senmag-robotics/Autgrip-Parts/3D_parts/actuator_spool.stl

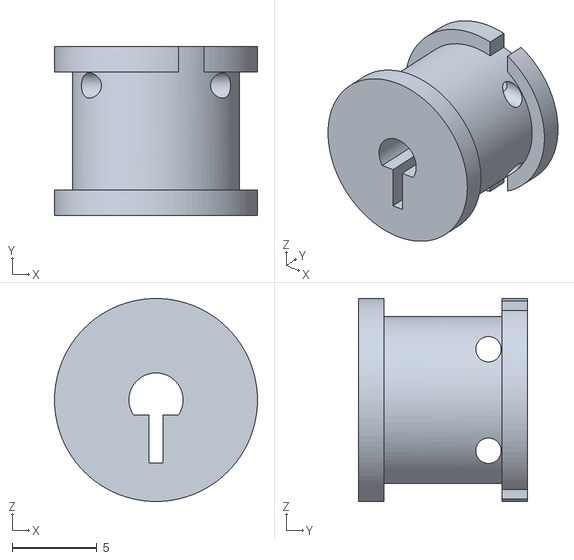
[picture p1: CAD file, 2020-12-04]
3D_parts/actuator_spool.stl
12.0 x 10.0 x 12.0
