senmag-robotics/Autgrip-Parts/3D_parts/gimbal_a.stl

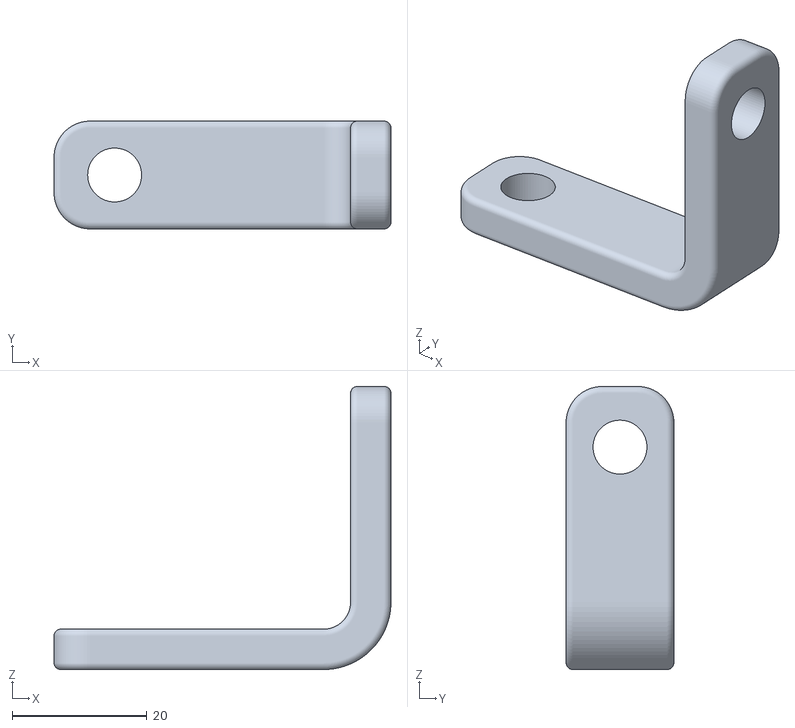
[picture p2: CAD file, 2020-12-04]
3D_parts/gimbal_a.stl
50.0 x 16.0 x 42.0
