senmag-robotics/Autgrip-Parts/3D_parts/gimbal_b.stl

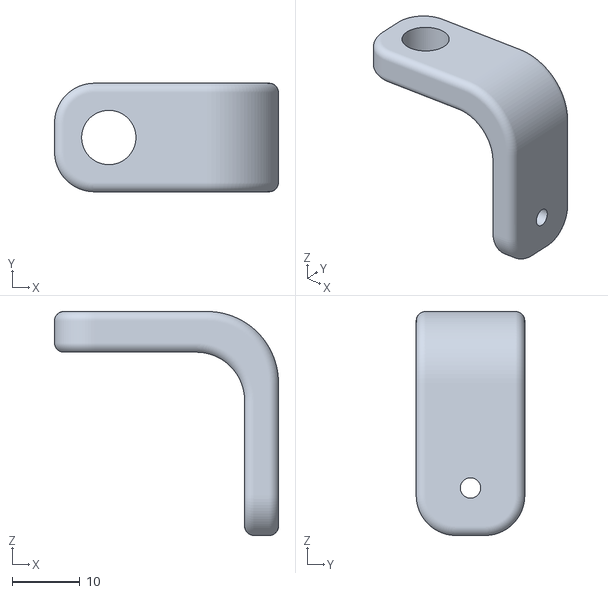
[picture p3: CAD file, 2020-12-04]
3D_parts/gimbal_b.stl
33.0 x 16.0 x 33.0
