senmag-robotics/Autgrip-Parts/3D_parts/thimble_a.stl

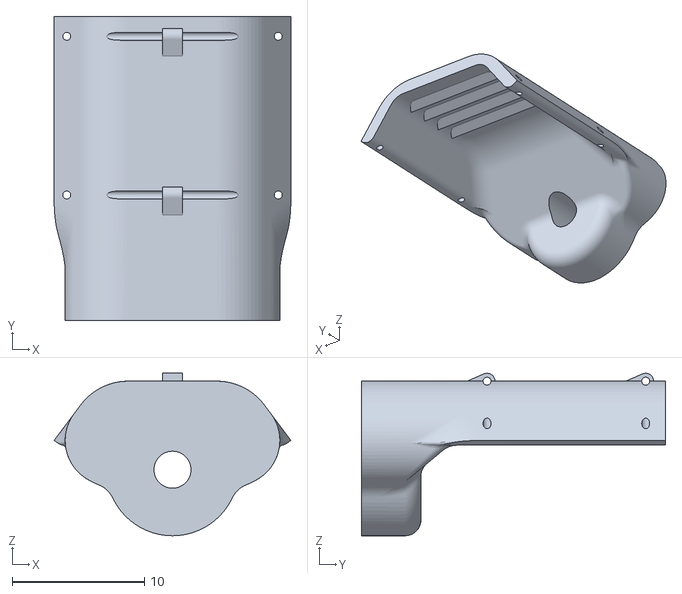
[picture p4: CAD file, 2020-12-04]
3D_parts/thimble_a.stl
17.9 x 23.0 x 12.3
