senmag-robotics/Autgrip-Parts/3D_parts/thimble_b.stl

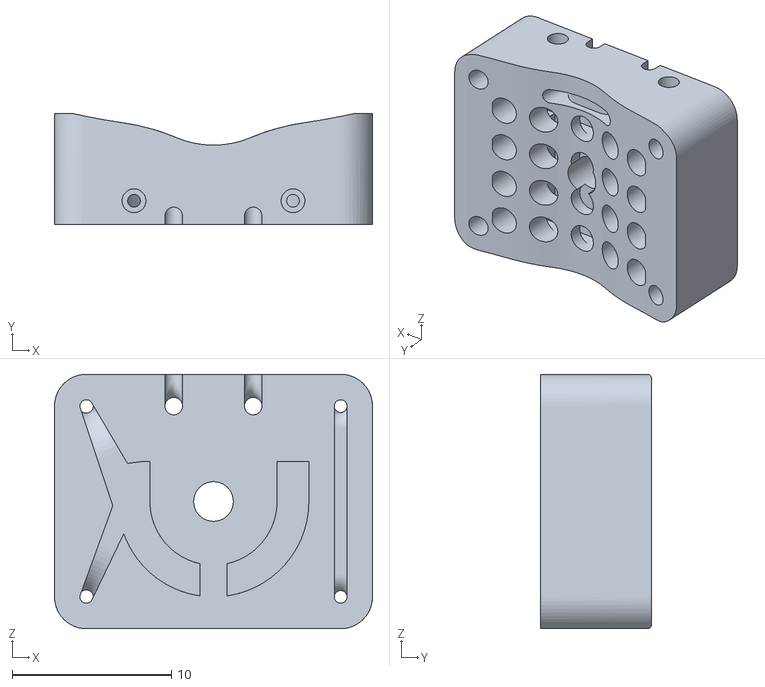
[picture p5: CAD file, 2020-12-04]
3D_parts/thimble_b.stl
20.0 x 7.00 x 16.0
