senmag-robotics/Autgrip-Parts/3D_parts/actuator_chassis.stl

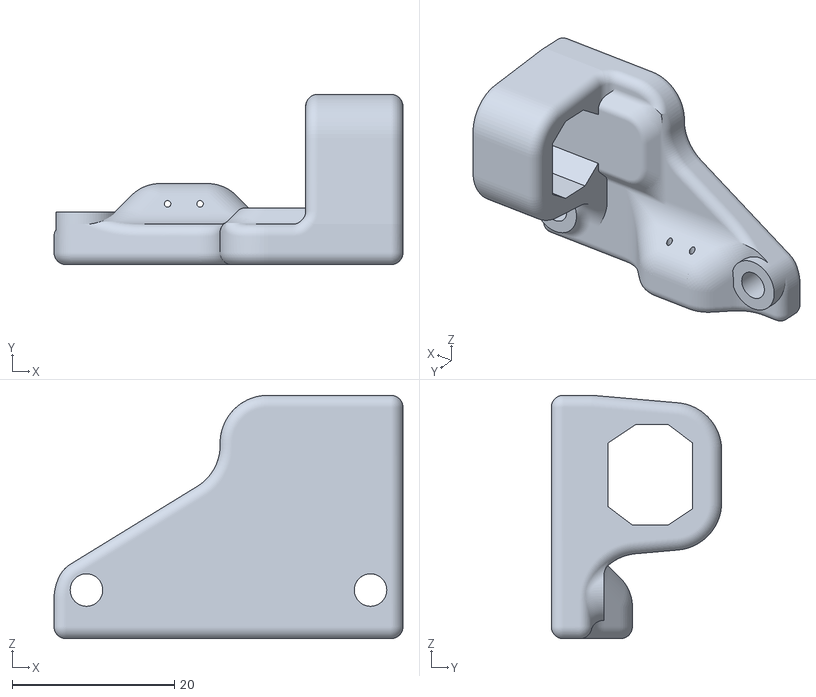
[picture p6: CAD file, 2020-12-04]
3D_parts/actuator_chassis.stl
43.0 x 21.0 x 30.0
