senmag-robotics/Autgrip-Parts/tutorial.pdf

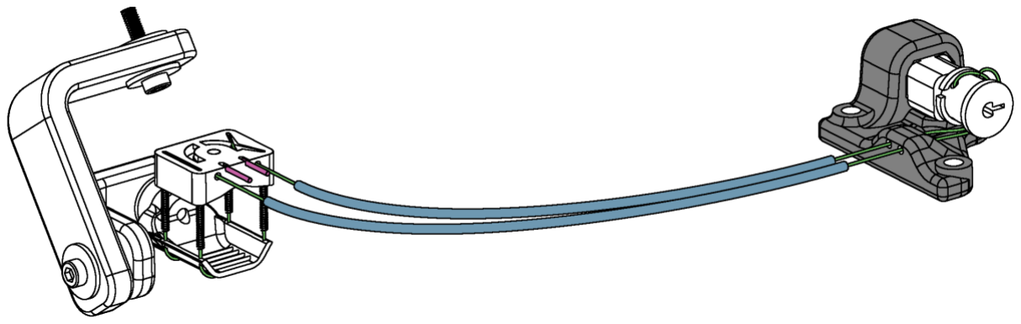
[picture p7: figure]

P a g e 1 | 12

# Autogrip Assembly Guide

# Version 1.0

## Table of Contents

## Introduction:

This document contains instructions for assembling Autogrip, an autonomously attaching thimble for haptic / force feedback devices.

The next section in this document is the part index. This lists all of the major components needed to assemble an Autogrip thimble. This is followed by sections of step-by-step instructions to assemble the parts.

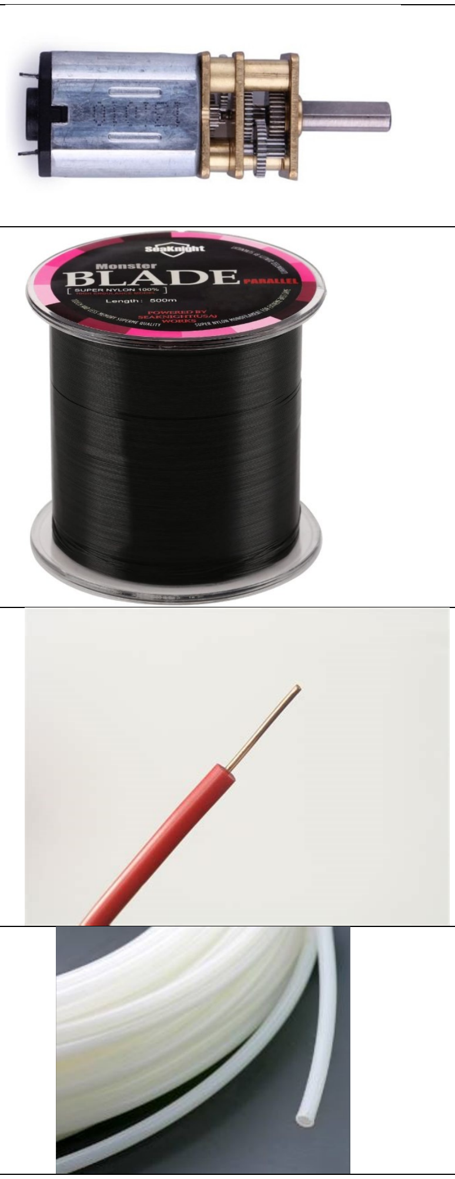
[picture p8: figure]

P a g e 2 | 12

## Part index:

Part reference | Description | Image
N20 Motor (30 RPM) | DC motor used for the actuator
Nylon fishing line (~0.5mm diameter) | Used to connect the actuator to the thimble sections
Electrical wire | Single core electrical wire for the capacitive sensor (remove insulation)
PTFE Teflon tube (~1mm ID, 2mm OD) | Used as Bowden tubes to connect the thimble to the actuator

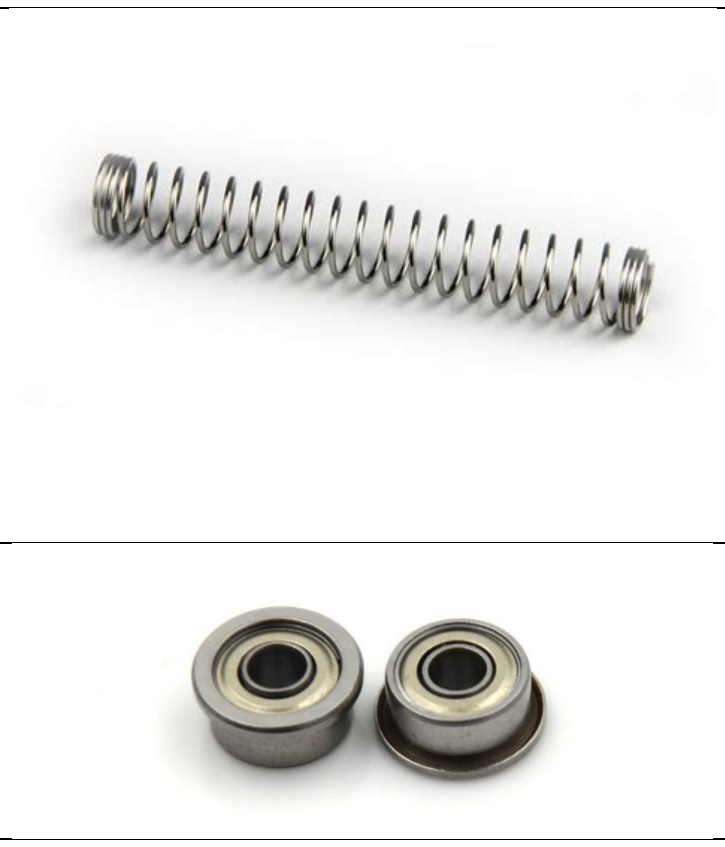
[picture p9: figure]
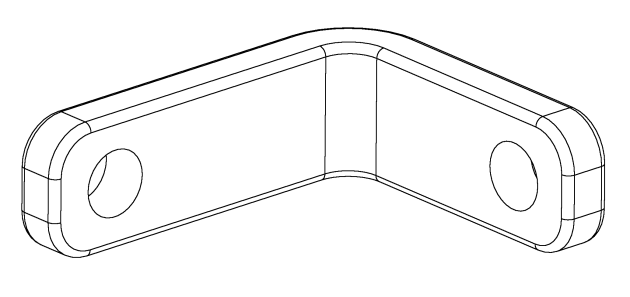
[picture p10: figure]
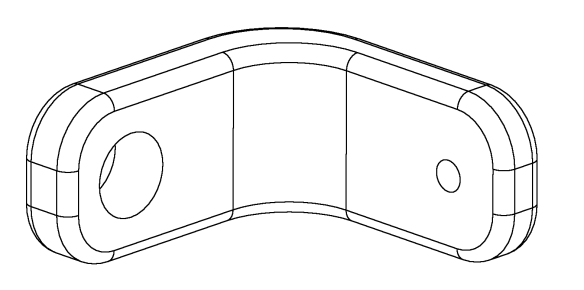
[picture p11: figure]

P a g e 3 | 12
Pen spring | Quantity: 4 Used to keep the thimble sections apart. Approx. 2mm diameter and 14mm length.
Flanged bearing (3mm ID, 8mm OD 9 mm flange) | Quantity: 6 Used for the gimbal sections
M3 15mm cap Bolt | Quantity: 3 Used for the gimbal sections
Gimbal part A | 3D printed (gimbal_a.stl) 100% infill wider nozzle is better (0.6-0.8mm)
Gimbal part B | 3D printed (gimbal_b.stl) 100% infill wider nozzle is better (0.6-0.8mm)

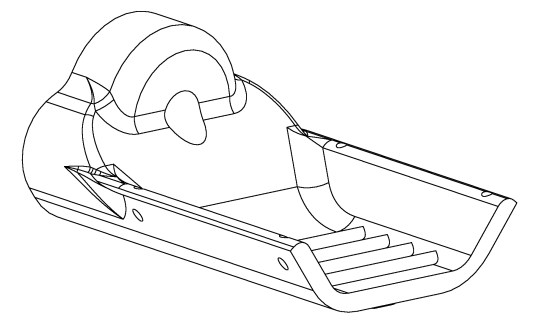
[picture p12: figure]
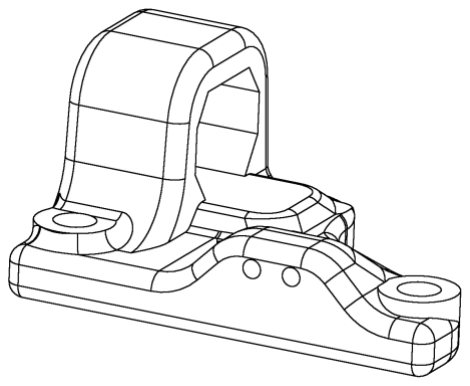
[picture p13: figure]

P a g e 4 | 12
Thimble part A | 3D printed (thimble_a.stl) 100% infill smaller nozzle is better (0.2-0.3mm)

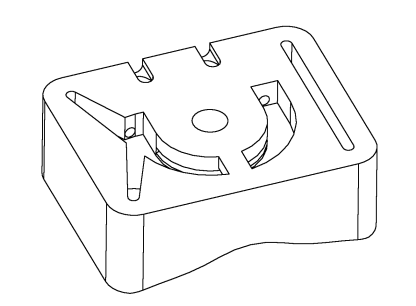
[picture p14: figure]

Thimble part B | 3D printed (thimble_b.stl) 100% infill smaller nozzle is better (0.2-0.3mm)
Actuator chassis | 3D printed (actuator_chassis.stl) medium infill wider nozzle is better (0.6-0.8mm)

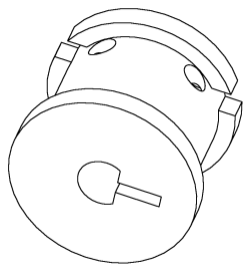
[picture p15: figure]

Actuator spool | 3D printed (actuator_spool.stl) 100% infill smaller nozzle is better (0.2-0.3mm)

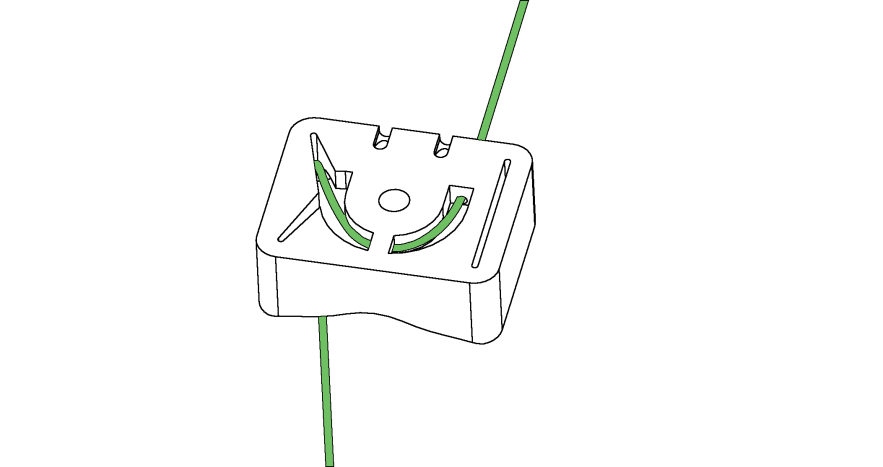
[picture p16: figure]

P a g e 5 | 12

## Assembly Guide:

### Step 1, cut the bowden tubes to length

Decide how long you want the Bowden cables for your thimble. We advise mounting the actuator near the base of the haptic device to reduce inertia. (we used roughly 40cm for a phantom 1.5)

Cut two lengths of PTFE tube with scissors or wire cutters.

### Step 2, start winding the fishing line through the thimble

Take the end of the fishing line (do not cut it from the reel yet) and pass it through Thimble part B as shown:

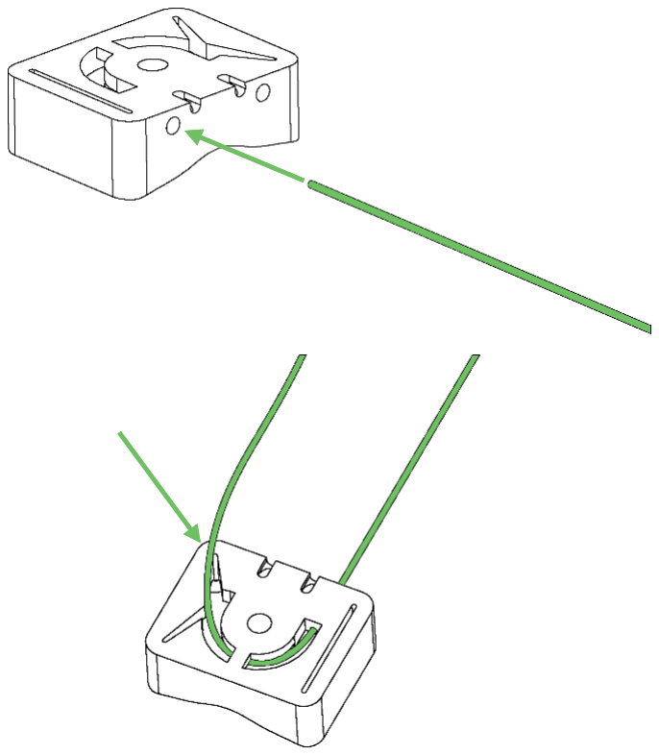
[picture p17: figure]
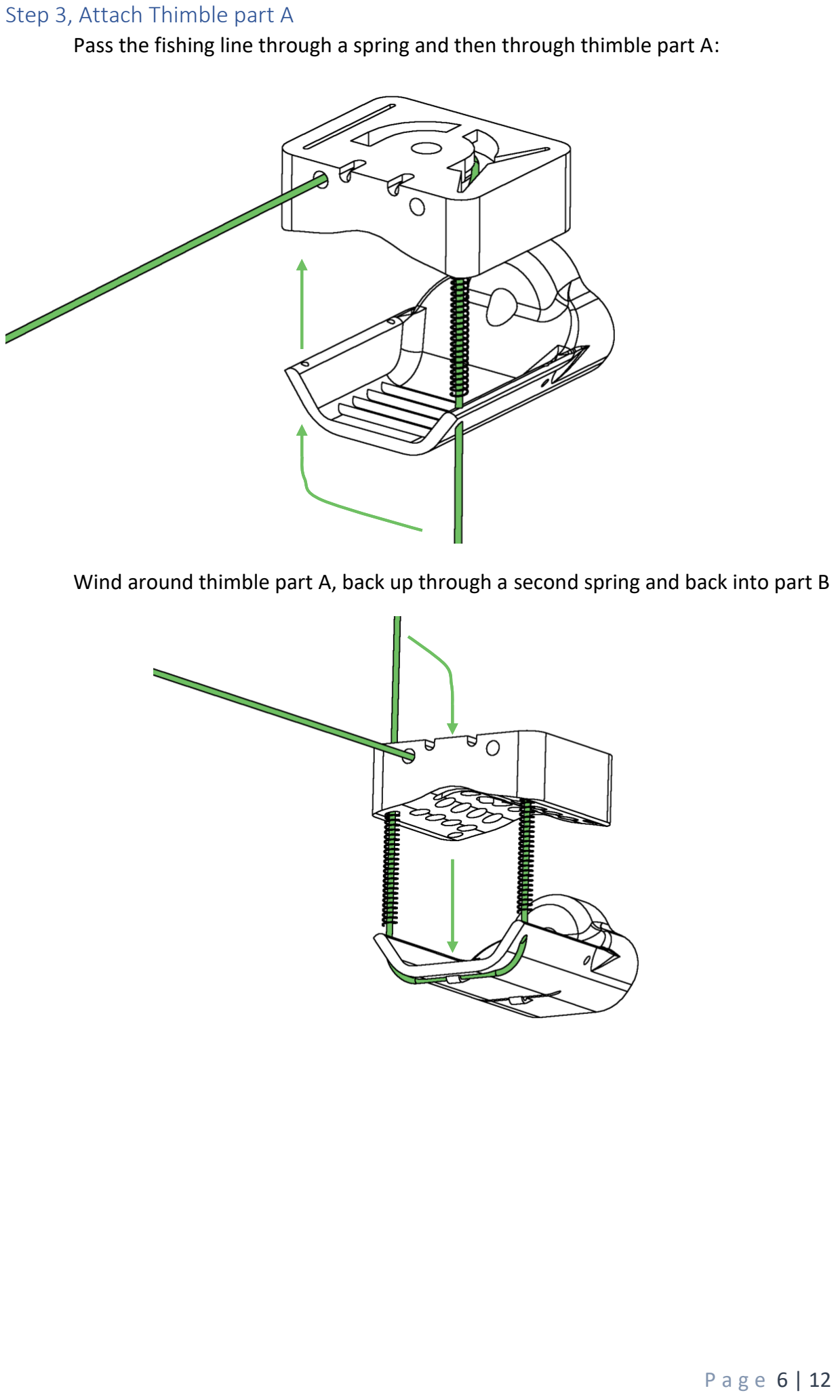
[picture p18: page 6]

P a g e 6 | 12

### Step 3, Attach Thimble part A

Pass the fishing line through a spring and then through thimble part A:

### Step 4, Wind the second half of thimble part A

Wind around thimble part A, back up through a second spring and back into part B

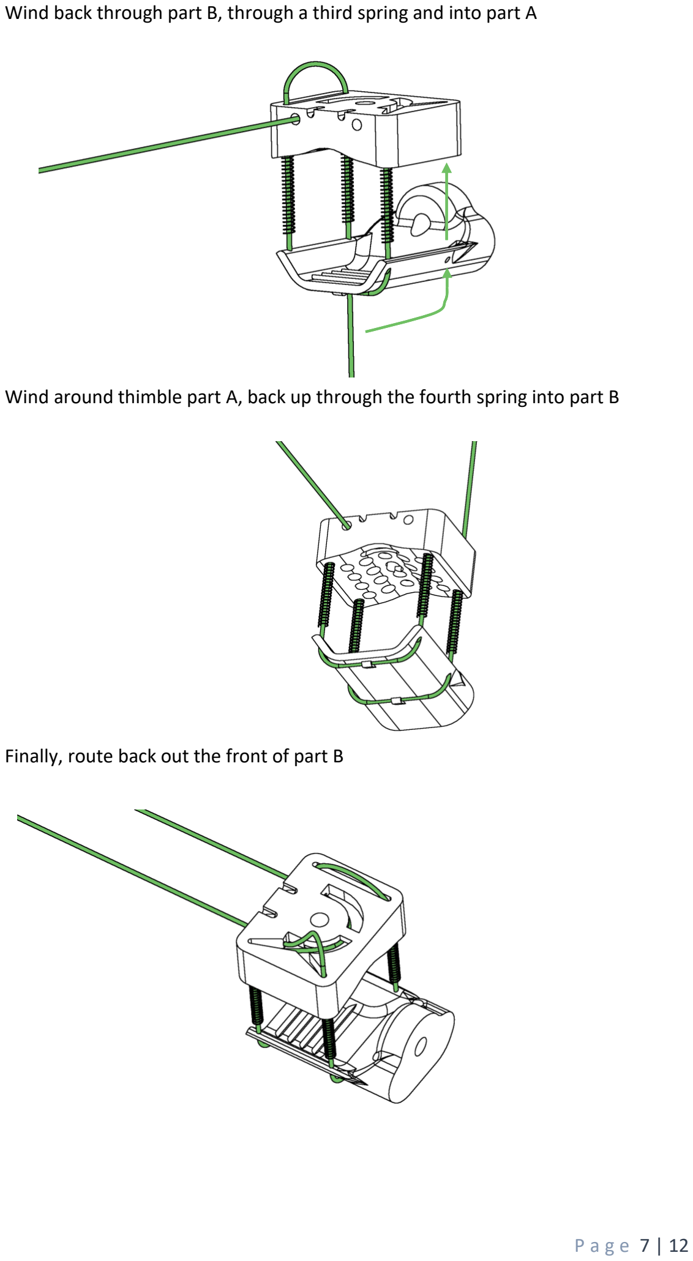
[picture p19: page 7]

P a g e 7 | 12

Wind back through part B, through a third spring and into part A

Wind around thimble part A, back up through the fourth spring into part B

Finally, route back out the front of part B

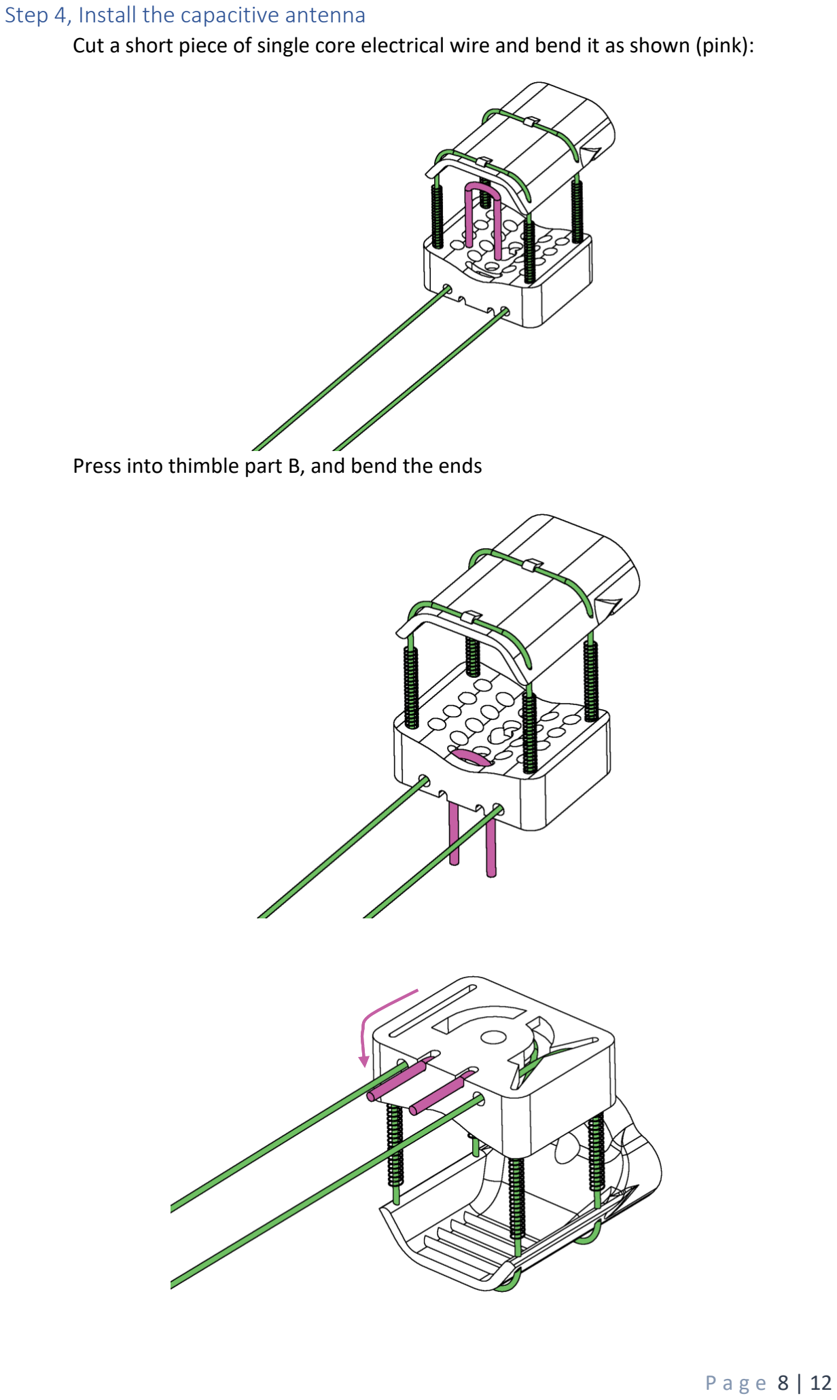
[picture p20: page 8]

P a g e 8 | 12

### Step 4, Install the capacitive antenna

Cut a short piece of single core electrical wire and bend it as shown (pink):

Press into thimble part B, and bend the ends

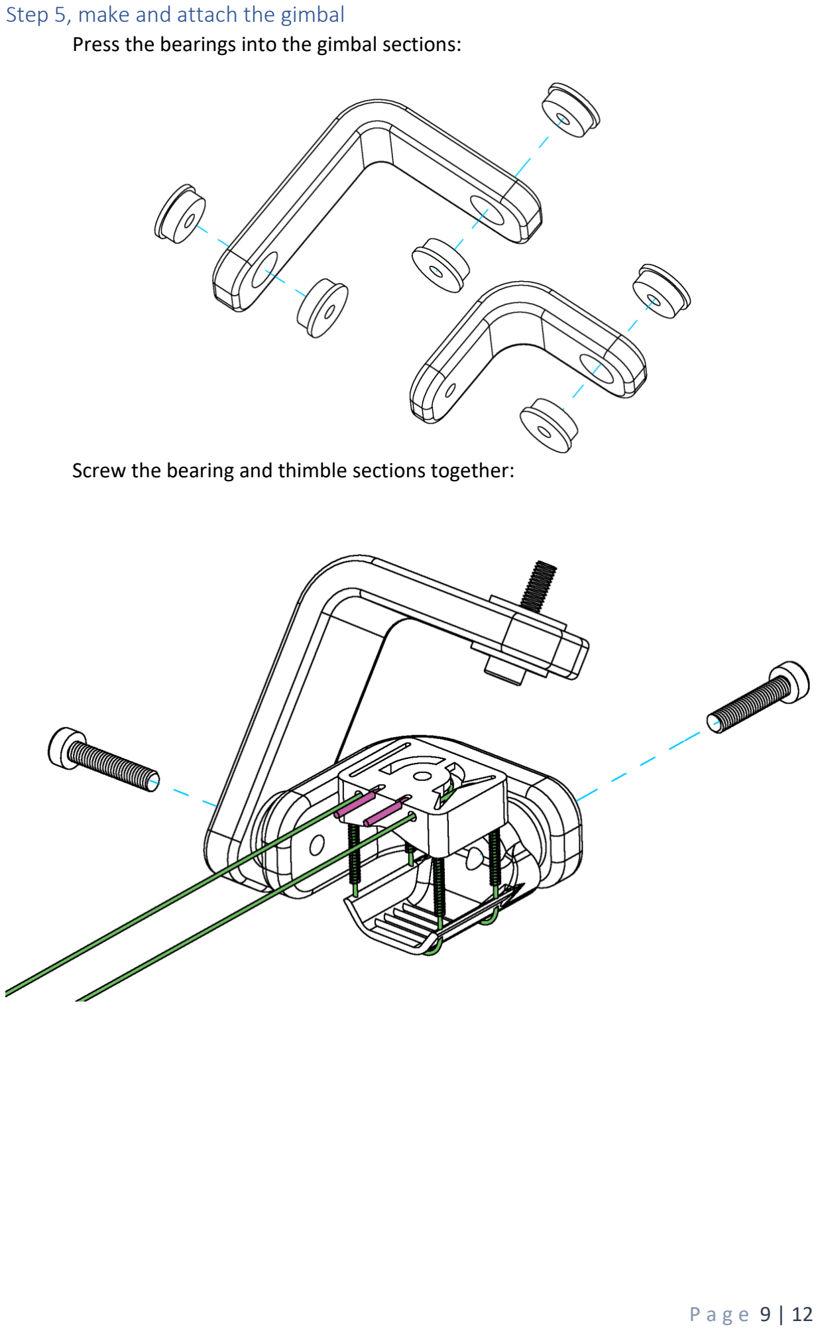
[picture p21: page 9]

P a g e 9 | 12

### Step 5, make and attach the gimbal

Press the bearings into the gimbal sections:

Screw the bearing and thimble sections together:

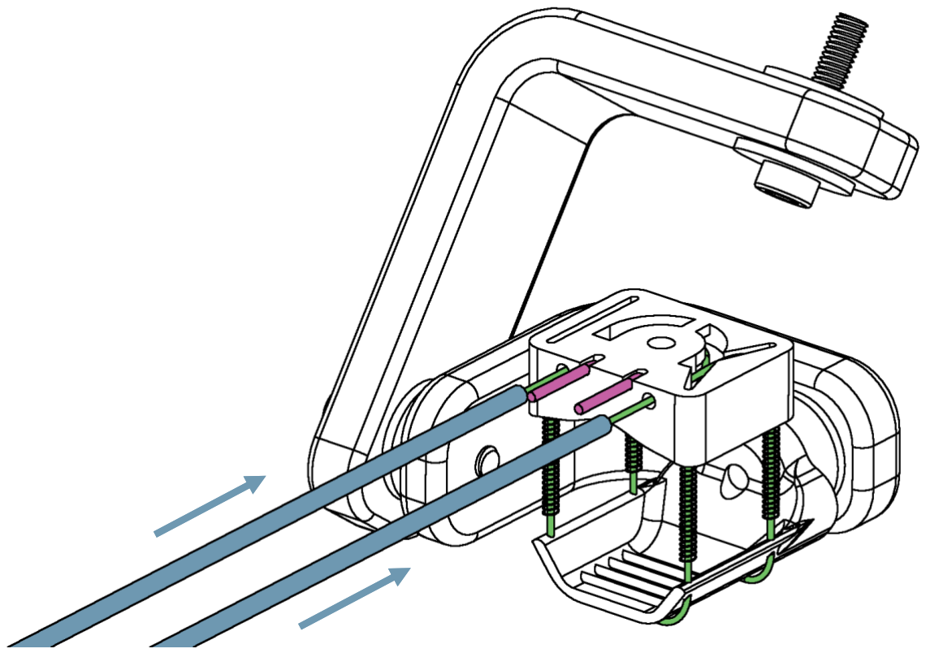
[picture p22: figure]

P a g e 10 | 12

### Step 5, install the Bowden tubes

Cut the fishing line to length with scissors. Leave plenty of length to ensure both ends are long enough to pass through the Bowden tubes and tie onto the actuator.

Slide the fishing lines through the PTFE tubes from step1 (blue):

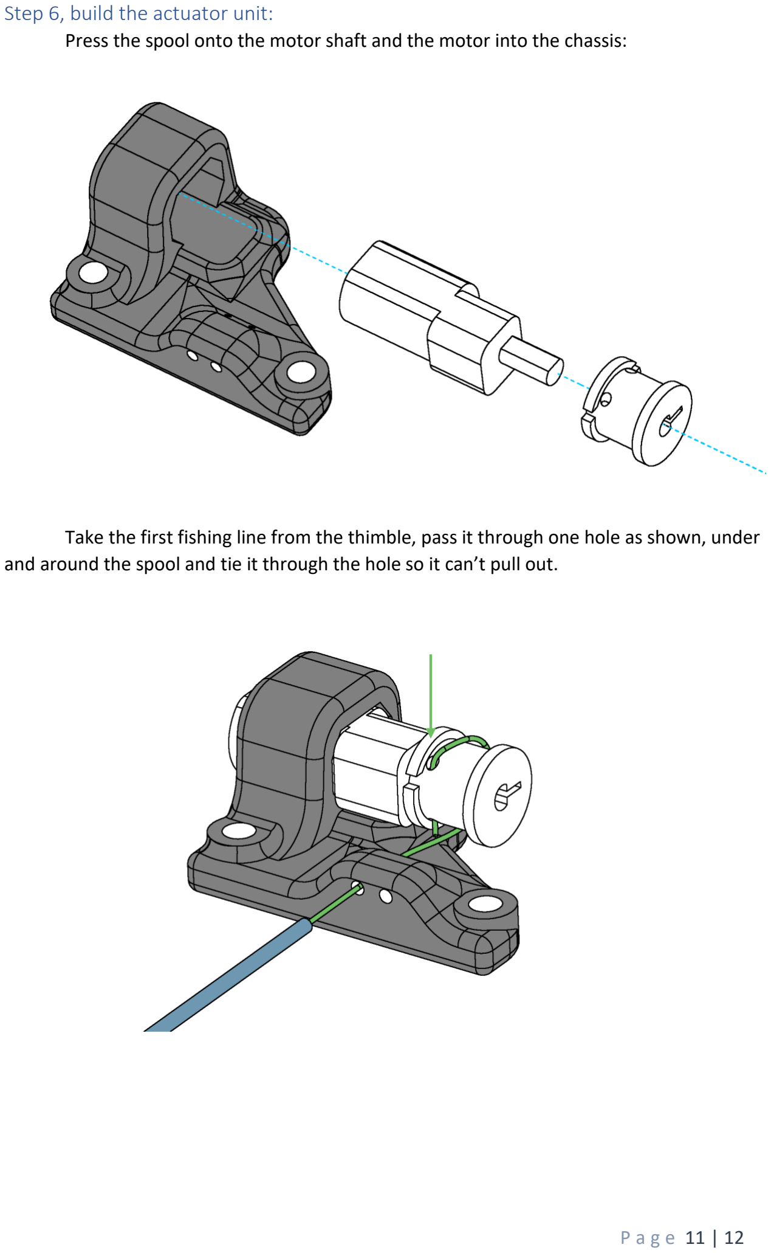
[picture p23: page 11]

P a g e 11 | 12

### Step 6, build the actuator unit:

Press the spool onto the motor shaft and the motor into the chassis:

Take the first fishing line from the thimble, pass it through one hole as shown, under and around the spool and tie it through the hole so it can’t pull out.

Repeat with the other end of the fishing line, using the second hole on the spool.

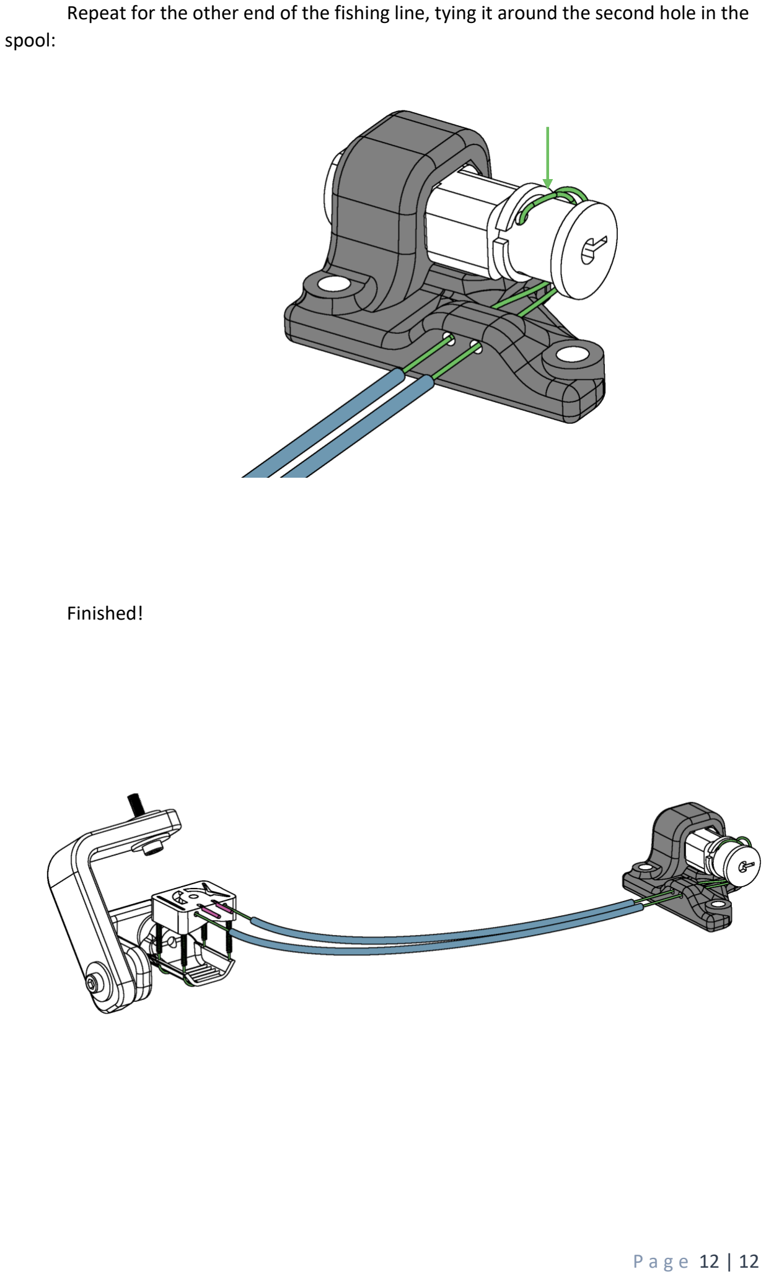
[picture p24: page 12]

P a g e 12 | 12

Repeat for the other end of the fishing line, tying it around the second hole in the spool:

Finished!
